Alexandr-Filatov/CAN_Sensor_PCB/3D/CAN_Sensor_PCB_VER1.0.step

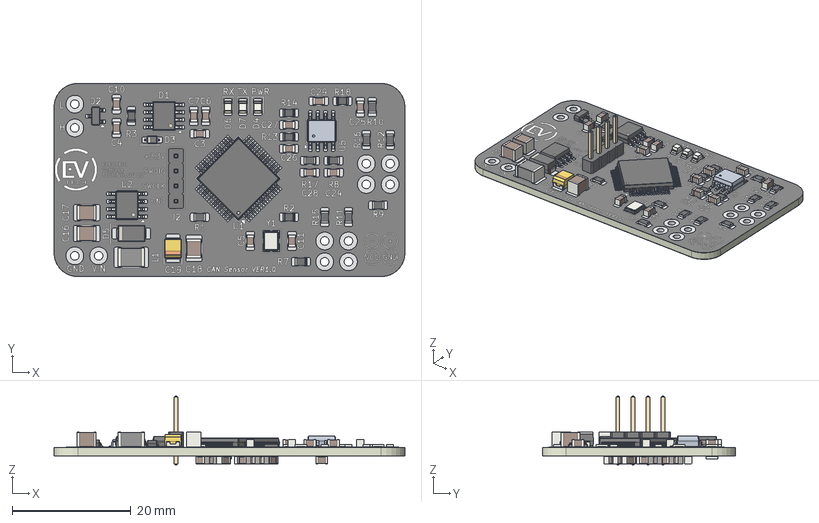
[picture p1: CAD file, 2025-06-19]
3D/CAN_Sensor_PCB_VER1.0.step
59.0 x 32.5 x 11.5 mm
C_0805_2012Metric x 24
R_0805_2012Metric x 18
Crystal_SMD_SeikoEpson_FA238-4Pin_3.2x2.5mm
C_1210_3225Metric x 3
CAN_Sensor_PCB_VER1.0 1.5.1
LQFP-64_10x10mm_P0.5mm
SOIC-8_3.9x4.9mm_P1.27mm x 2
LED_0805_2012Metric x 3
D_SMA
L_1812_4532Metric
D_SOD-323
PinHeader_1x04_P2.54mm_Vertical
SOT-23
CP_EIA-3528-21_Kemet-B
CAN_Sensor_PCB_copper
CAN_Sensor_PCB_pad
CAN_Sensor_PCB_via
CAN_Sensor_PCB_silkscreen
CAN_Sensor_PCB_soldermask
CAN_Sensor_PCB_PCB
