Alexandr-Filatov/CAN_Sensor_PCB/(list of files, cad)

Other CAD files:
Docs/НВЦТ.ДТН.0000.100.dwg
