Alexandr-Filatov/CAN_Sensor_PCB/Docs/НВЦТ.ДТН.0000.100.pdf

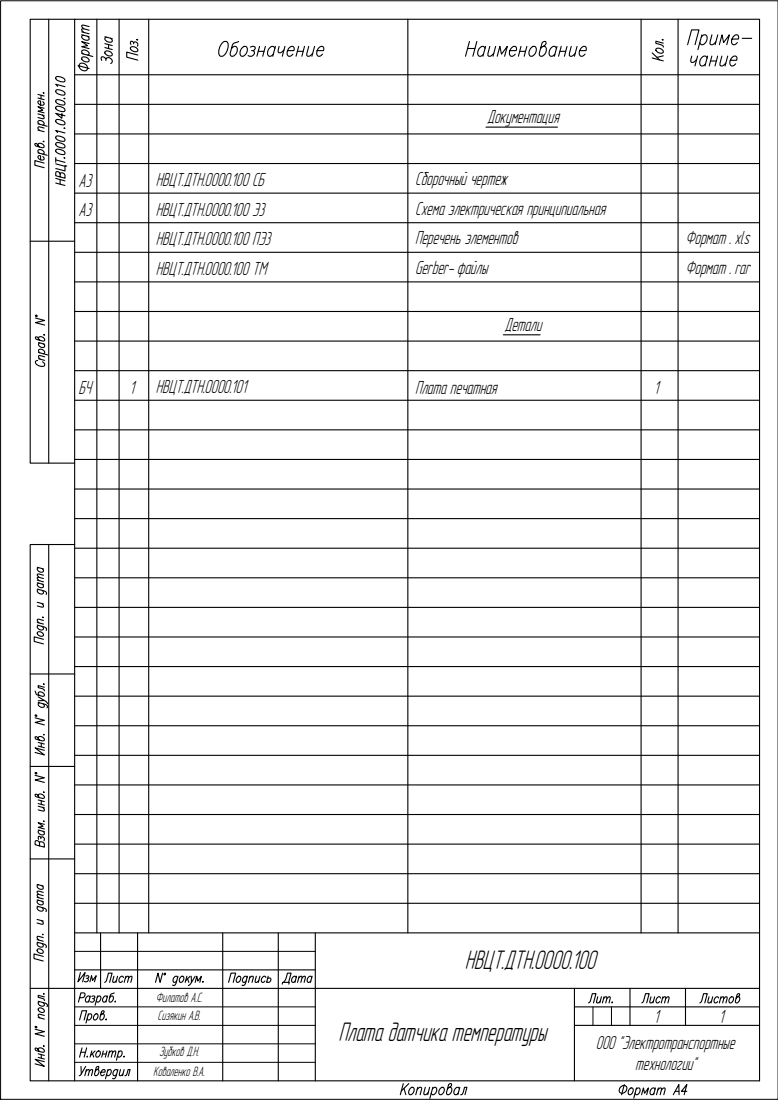
[picture p3: page 1]
НВЦТ.ДТН.0000.100 ТМ; Gerber- файлы; Формат . rar; Формат . xls; НВЦТ.ДТН.0000.101; Плата печатная; Филатов А.С. Сизякин А.В.

А3 | НВЦТ.ДТН.0000.100 СБ | Сборочный чертеж
А3 | НВЦТ.ДТН.0000.100 Э3 | Схема электрическая принципиальная

НВЦТ.ДТН.0000.100 ПЭ3 | Перечень элементов

Зубков Д.Н.
Коваленко В.А.
