Alexandr-Filatov/CAN_Sensor_PCB/Docs/НВЦТ.ДТН.0000.100 СБ.pdf

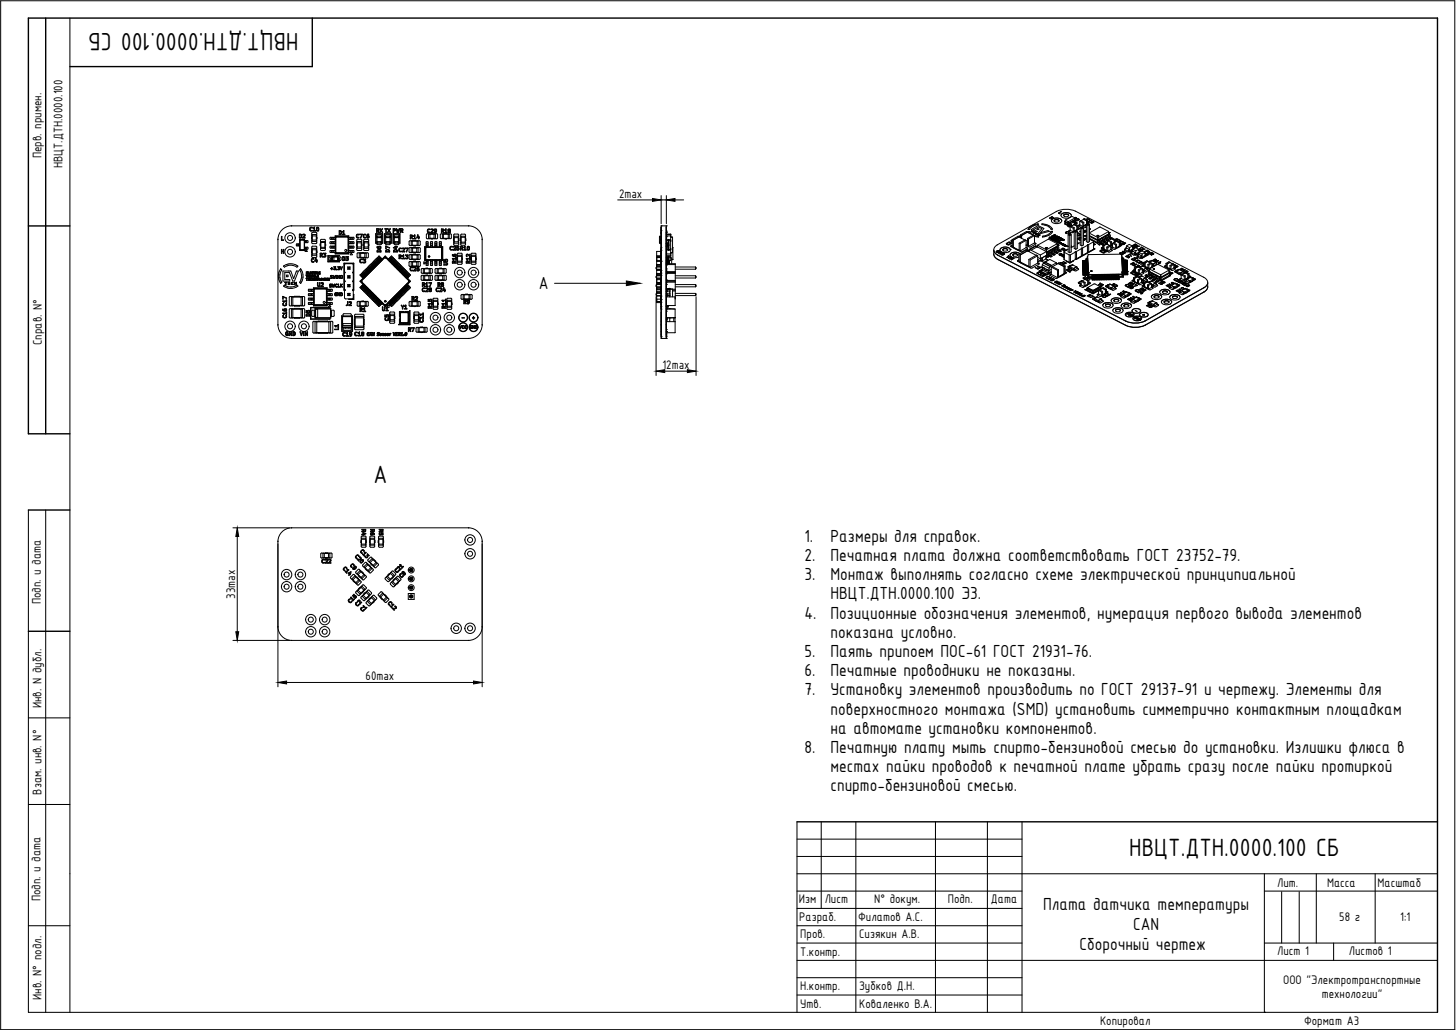
[picture p4: page 1]
Копировал; Формат А3; N° докум.; Т.контр.; Лист 1; Листов 1; Сизякин А.В.; Коваленко В.А.; Зубков Д.Н.; Филатов А.С.; Сборочный чертеж; технологии" Перв. примен. Подп. и дата Взам. инв. N° Подп. и дата Инв. N дубл. Справ. N°; 33max; 12max НВЦТ.ДТН.0000.100

1. Размеры для справок. 2. Печатная плата должна соответствовать ГОСТ 23752-79.

3. Монтаж выполнять согласно схеме электрической принципиальной
НВЦТ.ДТН.0000.100 Э3.
4. Позиционные обозначения элементов, нумерация первого вывода элементов
показана условно. 5. Паять припоем ПОС-61 ГОСТ 21931-76.

6. Печатные проводники не показаны. 7. Установку элементов производить по ГОСТ 29137-91 и чертежу. Элементы для

поверхностного монтажа (SMD) установить симметрично контактным площадкам
на автомате установки компонентов. 8. Печатную плату мыть спирто-бензиновой смесью до установки. Излишки флюса в

местах пайки проводов к печатной плате убрать сразу после пайки протиркой
спирто-бензиновой смесью. Пров.

НВЦТ.ДТН.0000.100 СБ

Плата датчика температуры

ООО "Электротранспортные Инв. N° подл.
