Alexandr-Filatov/CAN_Sensor_PCB/CAN_Sensor_PCB.kicad_pcb

## KiCad design CAN_Sensor_PCB.kicad_pcb (2025-06-19)

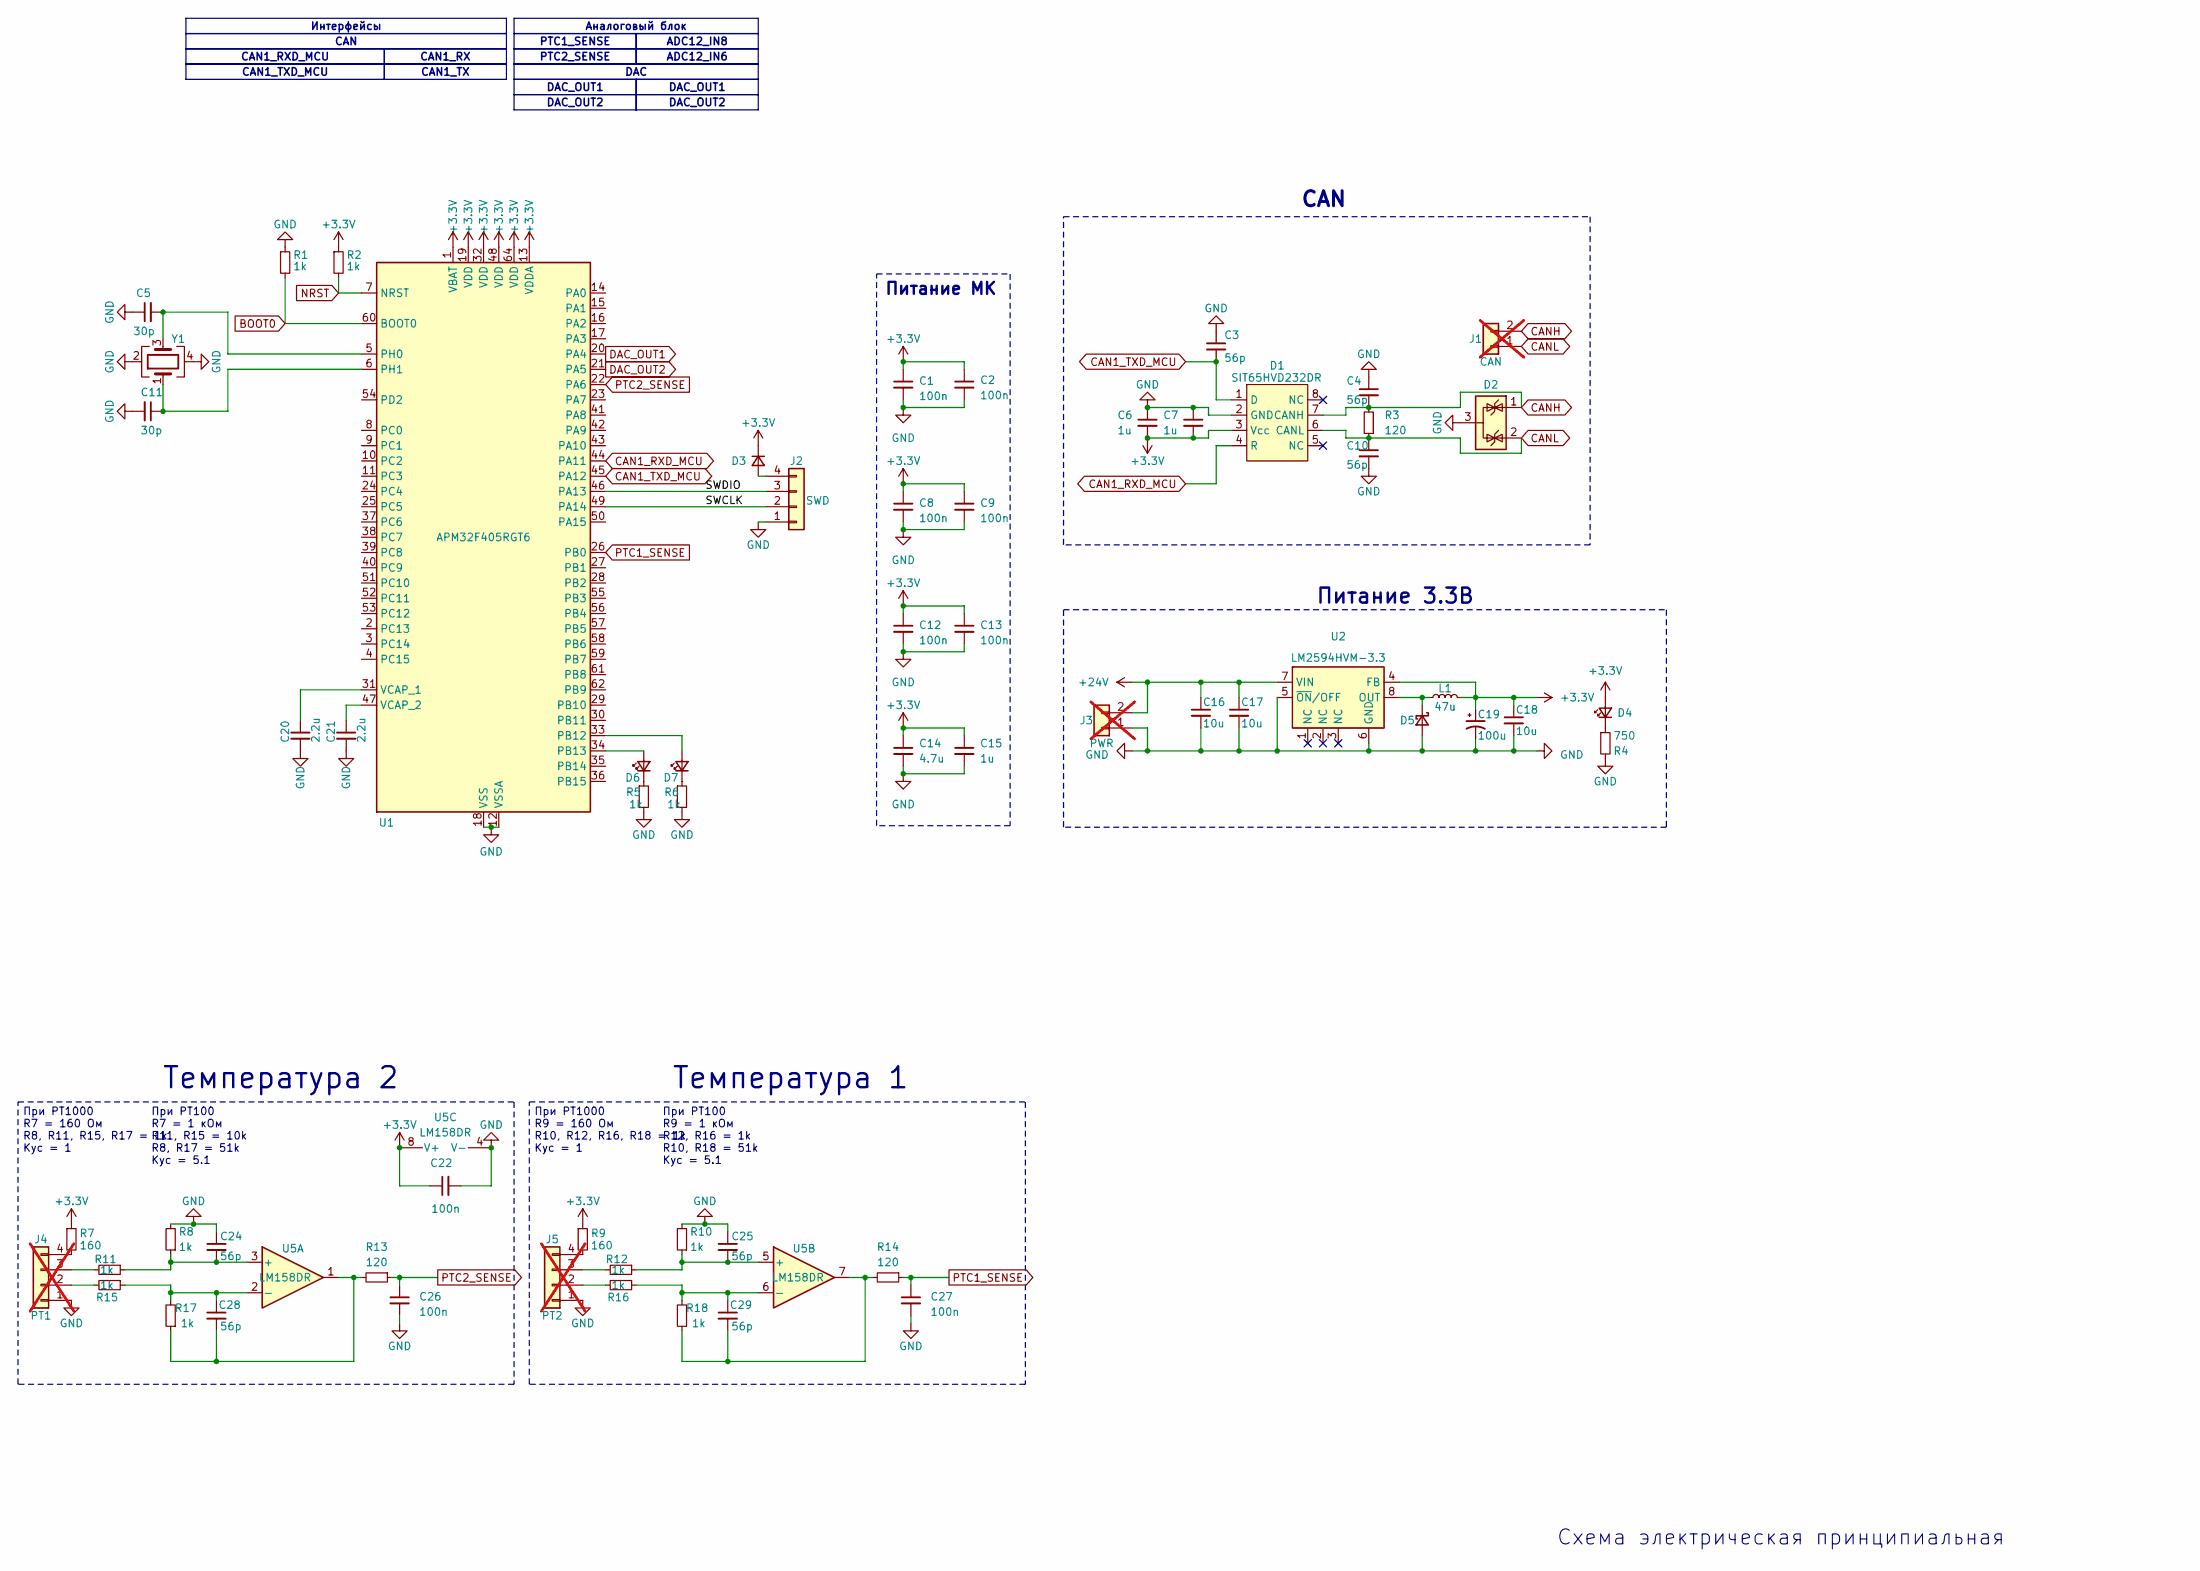
[picture p5: schematic CAN_Sensor_PCB.kicad_sch, Датчик температуры CAN]

Parts:
C1, C2, C8, C9, C12, C13, C22, C26, C27: 100n; C_0805_2012Metric_Pad1.18x1.45mm_HandSolder
C3, C4, C10, C24, C25, C28, C29: 56p; C_0805_2012Metric_Pad1.18x1.45mm_HandSolder
C5, C11: 30p; C_0805_2012Metric_Pad1.18x1.45mm_HandSolder
C6, C7, C15: 1u; C_0805_2012Metric_Pad1.18x1.45mm_HandSolder
C14: 4.7u; C_0805_2012Metric_Pad1.18x1.45mm_HandSolder
C16, C17, C18: 10u; C_1210_3225Metric_Pad1.33x2.70mm_HandSolder
C19: 100u; CP_EIA-3528-21_Kemet-B_HandSolder
C20, C21: 2.2u; C_0805_2012Metric_Pad1.18x1.45mm_HandSolder
D1: SOIC-8_3.9x4.9mm_P1.27mm
D2: SOT-23
D3: D_SOD-323_HandSoldering
D4, D6, D7: LED_0805_2012Metric
D5: D_SMA
J1, J3: Wire_1.5mm; not fitted
J2: PinHeader_1x04_P2.54mm_Vertical
J4, J5: Wire_1.5mm x 4; not fitted
L1: 47u; L_1812_4532Metric_Pad1.30x3.40mm_HandSolder
R1, R2, R5, R6, R8, R10, R11, R12, R15, R16, R17, R18: 1k; R_0805_2012Metric_Pad1.20x1.40mm_HandSolder
R3, R13, R14: 120; R_0805_2012Metric_Pad1.20x1.40mm_HandSolder
R4: 750; R_0805_2012Metric_Pad1.20x1.40mm_HandSolder
R7, R9: 160; R_0805_2012Metric_Pad1.20x1.40mm_HandSolder
U1: LQFP-64_10x10mm_P0.5mm
U2: SOIC-8_3.9x4.9mm_P1.27mm
U5: SO-8_3.9x4.9mm_P1.27mm
Y1: Crystal_SMD_SeikoEpson_FA238-4Pin_3.2x2.5mm

Connections:
+3.3V: C1.1, C2.1, C6.2, C7.2, C8.1, C9.1, C12.1, C13.1, C14.1, C15.1, C18.1, C19.1, C22.1, D1.3 (Vcc), D3.1 (K), D4.2 (A), L1.2, R2.1, R7.1, R9.1, U1.1 (VBAT), U1.13 (VDDA), U1.19 (VDD), U1.32 (VDD), U1.48 (VDD), U1.64 (VDD), U2.4 (FB), U5.8 (V+)
+24V: C16.1, C17.1, J3.2, U2.7 (VIN)
/SWCLK: J2.2, U1.49 (PA14)
/SWDIO: J2.3, U1.46 (PA13)
BOOT0: R1.2, U1.60 (BOOT0)
CAN1_RXD_MCU: D1.4 (R), U1.44 (PA11)
CAN1_TXD_MCU: C3.2, D1.1 (D), U1.45 (PA12)
CANH: C4.2, D1.7 (CANH), D2.1 (K), J1.2, R3.2
CANL: C10.1, D1.6 (CANL), D2.2 (K), J1.1, R3.1
DAC_OUT1: U1.20 (PA4)
DAC_OUT2: U1.21 (PA5)
GND: C1.2, C2.2, C3.1, C4.1, C5.1, C6.1, C7.1, C8.2, C9.2, C10.2, C11.2, C12.2, C13.2, C14.2, C15.2, C16.2, C17.2, C18.2, C19.2, C20.2, C21.2, C22.2, C24.1, C25.1, C26.2, C27.2, D1.2 (GND), D2.3 (A), D5.2 (A), J2.1, J3.1, J4.1, J5.1, R1.1, R4.2, R5.2, R6.2, R8.2, R10.2, U1.12 (VSSA), U1.18 (VSS), U1.63 (VSS), U2.5 (~ON/OFF), U2.6 (GND), U5.4 (V-), Y1.2, Y1.4
NRST: R2.2, U1.7 (NRST)
unnamed: C28.2, R13.2, R17.1, U5.1
unnamed: C29.2, R14.2, R18.1, U5.7
unnamed: D3.2 (A), J2.4
unnamed: D4.1 (K), R4.1
unnamed: D5.1 (K), L1.1, U2.8 (OUT)
unnamed: D6.2 (A), U1.34 (PB13)
unnamed: D6.1 (K), R5.1
unnamed: D7.2 (A), U1.33 (PB12)
unnamed: D7.1 (K), R6.1
unnamed: J4.2, R15.2
unnamed: J4.3, R11.2
unnamed: J4.4, R7.2
unnamed: J5.2, R16.2
unnamed: J5.3, R12.2
unnamed: J5.4, R9.2
unnamed: C5.2, U1.5 (PH0), Y1.3
unnamed: C11.1, U1.6 (PH1), Y1.1
unnamed: C20.1, U1.31 (VCAP_1)
unnamed: C21.1, U1.47 (VCAP_2)
unnamed: C24.2, R8.1, R11.1, U5.3 (+)
unnamed: C28.1, R15.1, R17.2, U5.2 (-)
unnamed: C25.2, R10.1, R12.1, U5.5 (+)
unnamed: C29.1, R16.1, R18.2, U5.6 (-)
PTC1_SENSE: C27.1, R14.1, U1.26 (PB0)
PTC2_SENSE: C26.1, R13.1, U1.22 (PA6)

Notes on the sheet:
Кус = 5.1
При PT1000
R10, R12, R16, R18 = 1k
R7 = 160 Ом
Схема электрическая принципиальная
R8, R17 = 51k
R9 = 160 Ом
Температура 2
R12, R16 = 1k
Питание МК
Температура 1
Питание 3.3В
R7 = 1 кОм
R9 = 1 кОм
R11, R15 = 10k
При PT100
CAN
Кус = 1
R10, R18 = 51k
R8, R11, R15, R17 = 1k
DAC_OUT2
CAN1_RX
DAC_OUT1
PTC1_SENSE
CAN1_TXD_MCU
CAN1_TX
DAC_OUT2
ADC12_IN6
PTC2_SENSE
CAN1_RXD_MCU
Интерфейсы
DAC
Аналоговый блок
ADC12_IN8

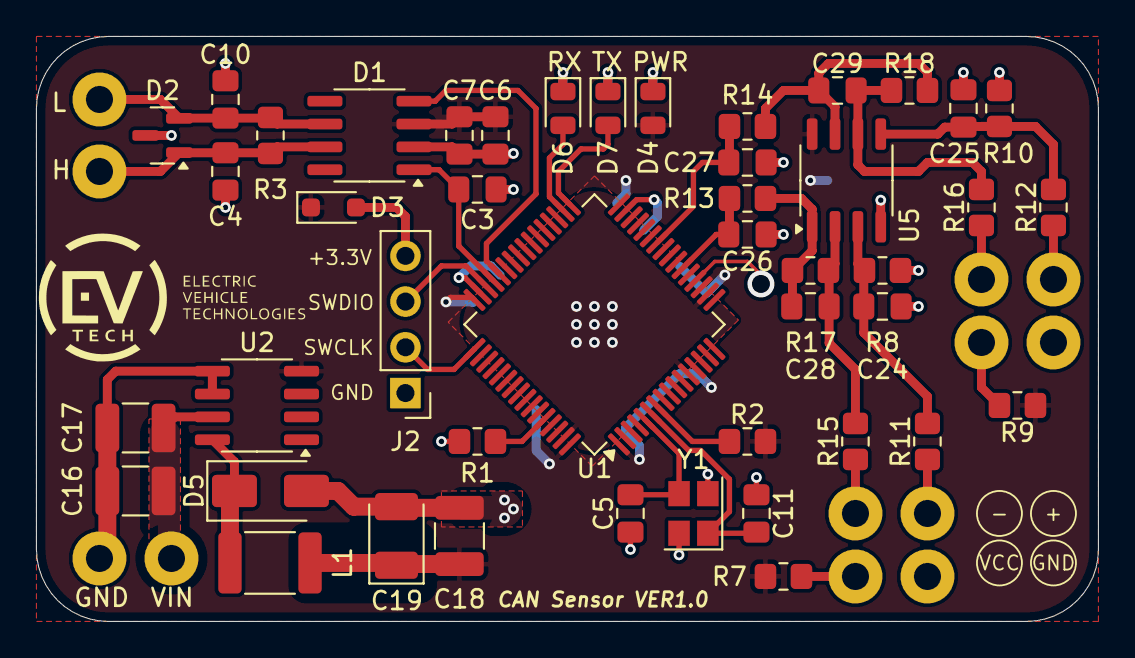
[picture p6: board CAN_Sensor_PCB.kicad_pcb from above]

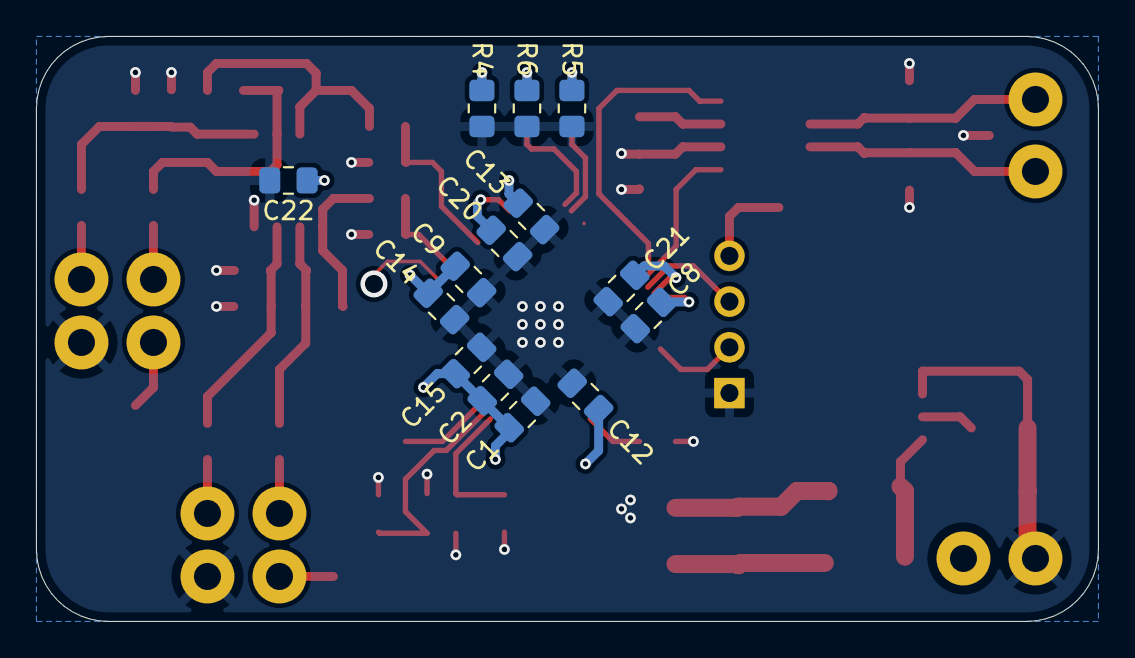
[picture p7: board CAN_Sensor_PCB.kicad_pcb from below]

Board: 2 copper layers, 59.0 x 32.5 mm, 63 parts (14 on the bottom side), 36 nets.
