Alexandr-Filatov/CAN_Sensor_PCB/(commit log)

2025-04-19 zero commit
    [CAN_Sensor_PCB.kicad_pcb, CAN_Sensor_PCB.kicad_sch]
2025-04-20 VER1.0: заменил два усилителя на один
    [CAN_Sensor_PCB.kicad_pcb]
2025-04-20 VER1.0: отправил в резонит
    [CAN_Sensor_PCB.kicad_pcb]
2025-04-21 VER1.0: добавил BOM и закупочный лист
    [CAN_Sensor_PCB.csv, CAN_Sensor_PCB.kicad_sch, CAN_Sensor_PCB.xlsx, CAN_Sensor_PCB_Закупочный лист.xlsx]
2025-06-19 VER1.0: добавил схему по госту в доки
    [CAN_Sensor_PCB.kicad_pcb, CAN_Sensor_PCB.kicad_sch, CAN_Sensor_PCB_VER1.0.step, CAN_Sensor_PCB_VER1.0_light.step]
2025-06-19 VER1.0: добавил спецификацию,3D, СБ в доки
    [CAN_Sensor_PCB_VER1.0.step]
2025-06-20 VER1.0: изменил спецификацию и рамку у СБ
2025-07-04 VER1.0: исправил СБ
2025-07-09 VER1.0: изменил вес линий в СБ
2025-07-10 VER1.0: изменил децимальники
2025-07-10 VER1.0: исправил Э3
    [CAN_Sensor_PCB.kicad_sch]
2025-07-10 VER1.0: исправил Э3 еще раз
2025-07-14 VER21.0: исправил Э3
    [CAN_Sensor_PCB.kicad_sch]
2025-07-15 VER1.0: переделал спецификацию в автокаде
    [НВЦТ.ДТН.0000.100.dwg]
2025-09-04 VER1.0: исправил номиналы резисторов для датчика и BOM
    [CAN_Sensor_PCB.csv, CAN_Sensor_PCB.kicad_sch, CAN_Sensor_PCB.xlsx, CAN_Sensor_PCB_Закупочный лист.xlsx]
2025-09-04 VER1.0: добавил матлаб модель с температурным контуром
